diwou/hubby_seventy_five/kicad/fab/rev0.3/bom/bom.csv

Designator | Footprint | Quantity | Value | LCSC Part #
BT1 | BatteryHolder_MYOUNG_BS-07-A1BJ001_CR2032 | 1 | CR2032
C1, C10, C11, C13, C2, C28, C3, C4, C7, C9 | 0805 | 10 | 100n
C12 | 0805 | 1 | 1µ
C27, C5, C6, C8 | 0805 | 4 | 10µ
D1 | D_SMA | 1 | SS14
D2 | 0805 | 1 | PWR
J1 | USB_C_Receptacle_GCT_USB4105-xx-A_16P_TopMnt_Horizontal | 1 | USB_C_Receptacle_USB2.0_16P
J2 | JST_VH_B4P-VH_1x04_P3.96mm_Vertical | 1 | PWR IN
J3 | IDC-Header_2x08_P2.54mm_Vertical | 1 | HUB75 Connector
R1, R2 | 0805 | 2 | 5k1
R10, R11, R6, R8, R9 | 0805 | 5 | 10k
R27 | 0805 | 1 | 10
R3, R4, R5 | 0805 | 3 | 4k7
R7 | 0805 | 1 | 1k
SW1 | SW_PUSH_6mm | 1 | Reset
SW2 | SW_PUSH_6mm | 1 | Factory Reset
SW3 | SW_PUSH_6mm | 1 | Boot
U1 | SOT-223-3_TabPin2 | 1 | TLV76133DCY
U2 | SOIC-16W_7.5x10.3mm_P1.27mm | 1 | DS3231S
U21 | XDCR_VEML7700-TT | 1 | VEML7700-TT
U3, U6 | TSSOP-20_4.4x6.5mm_P0.65mm | 2 | 74HCT245
U4 | Bosch_LGA-8_3x3mm_P0.8mm_ClockwisePinNumbering | 1 | BME680
U5 | ESP32-S3-WROOM-1 | 1 | ESP32-S3-WROOM-1
