diwou/hubby_seventy_five/kicad/source/Hubby Seventy Five.kicad_pcb

## KiCad design kicad/source/Hubby Seventy Five.kicad_pcb (2026-04-23)

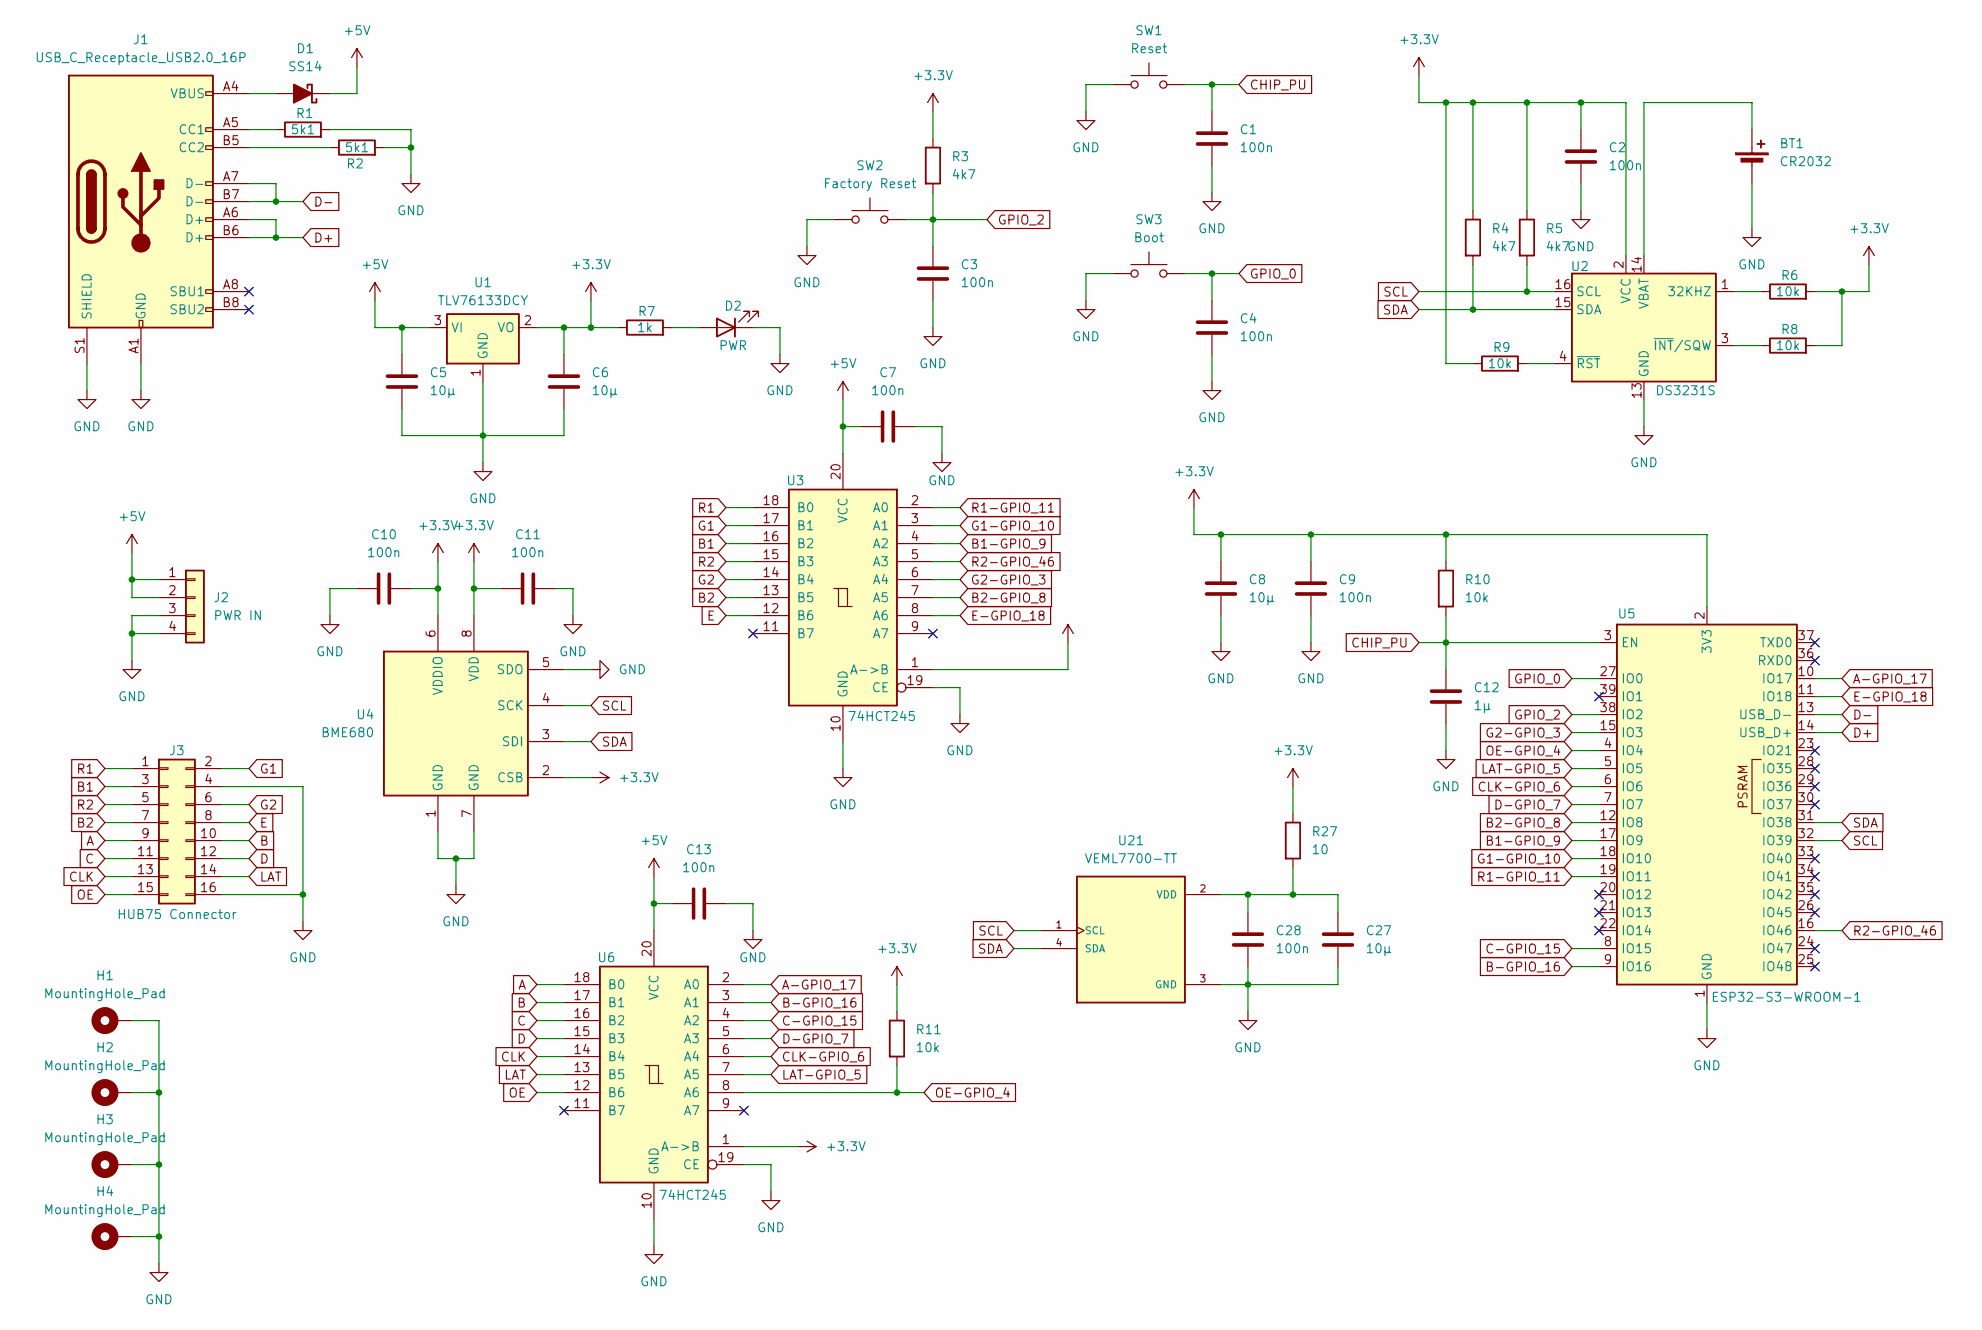
[picture p1: schematic Hubby Seventy Five.kicad_sch]

Parts:
BT1: CR2032; BatteryHolder_MYOUNG_BS-07-A1BJ001_CR2032
C1, C2, C3, C4, C7, C9, C10, C11, C13, C28: 100n; C_0805_2012Metric_Pad1.18x1.45mm_HandSolder
C5, C6, C8, C27: 10µ; C_0805_2012Metric_Pad1.18x1.45mm_HandSolder
C12: 1µ; C_0805_2012Metric_Pad1.18x1.45mm_HandSolder
D1: SS14; D_SMA
D2: PWR; LED_0805_2012Metric_Pad1.15x1.40mm_HandSolder
H1, H2, H3, H4: MountingHole_Pad; MountingHole_3.2mm_M3_DIN965_Pad
J1: USB_C_Receptacle_USB2.0_16P; USB_C_Receptacle_GCT_USB4105-xx-A_16P_TopMnt_Horizontal
J2: PWR IN; JST_VH_B4P-VH_1x04_P3.96mm_Vertical
J3: HUB75 Connector; IDC-Header_2x08_P2.54mm_Vertical
R1, R2: 5k1; R_0805_2012Metric_Pad1.20x1.40mm_HandSolder
R3, R4, R5: 4k7; R_0805_2012Metric_Pad1.20x1.40mm_HandSolder
R6, R8, R9, R10, R11: 10k; R_0805_2012Metric_Pad1.20x1.40mm_HandSolder
R7: 1k; R_0805_2012Metric_Pad1.20x1.40mm_HandSolder
R27: 10; R_0805_2012Metric_Pad1.20x1.40mm_HandSolder
SW1: Reset; SW_PUSH_6mm
SW2: Factory Reset; SW_PUSH_6mm
SW3: Boot; SW_PUSH_6mm
U1: TLV76133DCY; SOT-223-3_TabPin2
U2: DS3231S; SOIC-16W_7.5x10.3mm_P1.27mm
U3, U6: 74HCT245; TSSOP-20_4.4x6.5mm_P0.65mm
U4: BME680; Bosch_LGA-8_3x3mm_P0.8mm_ClockwisePinNumbering
U5: ESP32-S3-WROOM-1
U21: VEML7700-TT; XDCR_VEML7700-TT; PARTREV 1.6

Connections:
+3.3V: C2.1, C6.1, C8.1, C9.1, C10.2, C11.1, R3.1, R4.1, R5.1, R6.2, R7.1, R8.2, R9.1, R10.1, R11.1, R27.1, U1.2 (VO), U2.2 (VCC), U3.1 (A->B), U4.2 (CSB), U4.6 (VDDIO), U4.8 (VDD), U5.2 (3V3), U6.1 (A->B)
+5V: C5.1, C7.1, C13.1, D1.1 (K), J2.1, J2.2, U1.3 (VI), U3.20 (VCC), U6.20 (VCC)
A: J3.9, U6.18 (B0)
A-GPIO_17: U5.10 (IO17), U6.2 (A0)
B: J3.10, U6.17 (B1)
B1: J3.3, U3.16 (B2)
B1-GPIO_9: U3.4 (A2), U5.17 (IO9)
B2: J3.7, U3.13 (B5)
B2-GPIO_8: U3.7 (A5), U5.12 (IO8)
B-GPIO_16: U5.9 (IO16), U6.3 (A1)
C: J3.11, U6.16 (B2)
C-GPIO_15: U5.8 (IO15), U6.4 (A2)
CHIP_PU: C1.1, C12.1, R10.2, SW1.2, U5.3 (EN)
CLK: J3.13, U6.14 (B4)
CLK-GPIO_6: U5.6 (IO6), U6.6 (A4)
D: J3.12, U6.15 (B3)
D+: J1.A6 (D+), J1.B6 (D+), U5.14 (USB_D+)
D-: J1.A7 (D-), J1.B7 (D-), U5.13 (USB_D-)
D-GPIO_7: U5.7 (IO7), U6.5 (A3)
E: J3.8, U3.12 (B6)
E-GPIO_18: U3.8 (A6), U5.11 (IO18)
G1: J3.2, U3.17 (B1)
G1-GPIO_10: U3.3 (A1), U5.18 (IO10)
G2: J3.6, U3.14 (B4)
G2-GPIO_3: U3.6 (A4), U5.15 (IO3)
GND: BT1.2 (-), C1.2, C2.2, C3.2, C4.2, C5.2, C6.2, C7.2, C8.2, C9.2, C10.1, C11.2, C12.2, C13.2, C27.2, C28.2, D2.1 (K), H1.1, H2.1, H3.1, H4.1, J1.A1 (GND), J1.A12 (GND), J1.B1 (GND), J1.B12 (GND), J1.S1 (SHIELD), J2.3, J2.4, J3.4, J3.16, R1.2, R2.2, SW1.1, SW2.1, SW3.1, U1.1 (GND), U2.5 (GND), U2.6 (GND), U2.7 (GND), U2.8 (GND), U2.9 (GND), U2.10 (GND), U2.11 (GND), U2.12 (GND), U2.13 (GND), U3.10 (GND), U3.19 (CE), U4.1 (GND), U4.5 (SDO), U4.7 (GND), U5.1 (GND), U5.40 (GND), U5.41 (GND), U6.10 (GND), U6.19 (CE), U21.3 (GND)
GPIO_0: C4.1, SW3.2, U5.27 (IO0)
GPIO_2: C3.1, R3.2, SW2.2, U5.38 (IO2)
LAT: J3.14, U6.13 (B5)
LAT-GPIO_5: U5.5 (IO5), U6.7 (A5)
unnamed: BT1.1 (+), U2.14 (VBAT)
unnamed: D1.2 (A), J1.A4 (VBUS), J1.A9 (VBUS), J1.B4 (VBUS), J1.B9 (VBUS)
unnamed: D2.2 (A), R7.2
unnamed: J1.A5 (CC1), R1.1
unnamed: J1.B5 (CC2), R2.1
unnamed: R6.1, U2.1 (32KHZ)
unnamed: R8.1, U2.3 (~INT/SQW)
unnamed: R9.2, U2.4 (~RST)
unnamed: C27.1, C28.1, R27.2, U21.2 (VDD)
OE: J3.15, U6.12 (B6)
OE-GPIO_4: R11.2, U5.4 (IO4), U6.8 (A6)
R1: J3.1, U3.18 (B0)
R1-GPIO_11: U3.2 (A0), U5.19 (IO11)
R2: J3.5, U3.15 (B3)
R2-GPIO_46: U3.5 (A3), U5.16 (IO46)
SCL: R5.2, U2.16 (SCL), U4.4 (SCK), U5.32 (IO39), U21.1 (SCL)
SDA: R4.2, U2.15 (SDA), U4.3 (SDI), U5.31 (IO38), U21.4 (SDA)

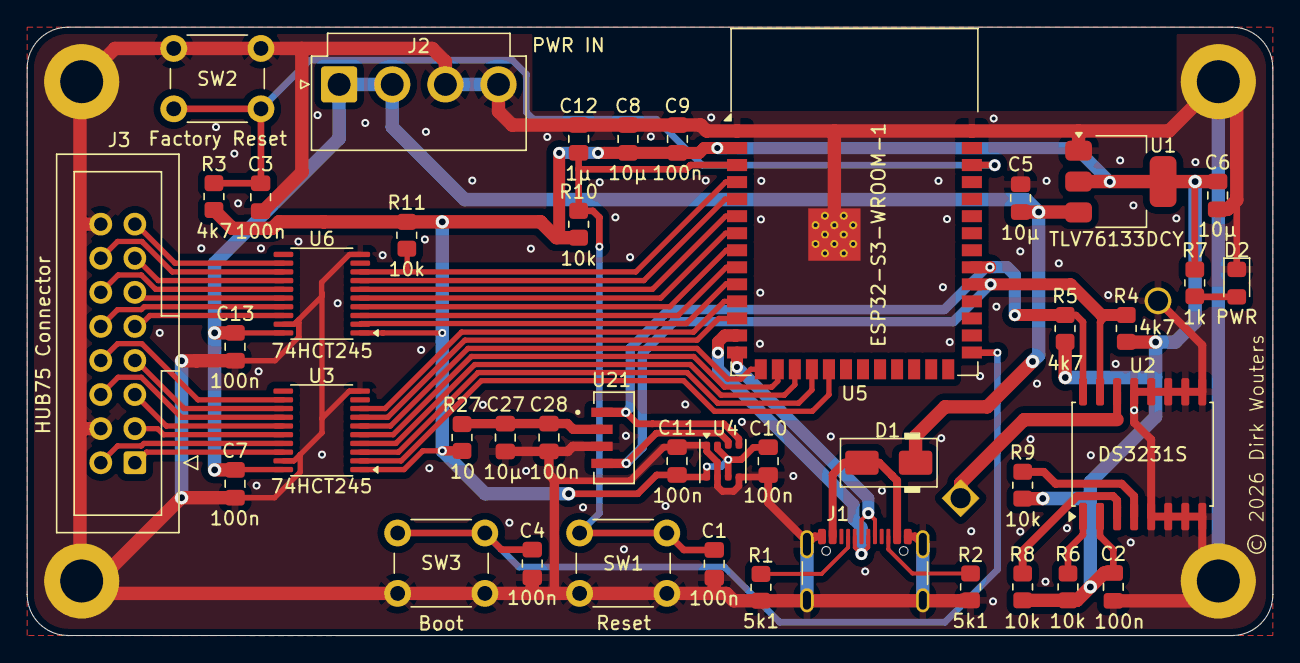
[picture p2: board Hubby Seventy Five.kicad_pcb from above]

Board: 2 copper layers, 92.8 x 45.3 mm, 47 parts (1 on the bottom side), 47 nets.
