diwou/hubby_seventy_five/(commit log)

2026-04-06 Add installer button to README
2026-04-10 fix: refine forecast spacing and enlarge clock
    [display.h]
2026-04-10 fix: use taller hhmm clock glyphs
    [display.h]
2026-04-10 fix: replace ineffective clock scaling with tall hhmm renderer
    [display.h]
2026-04-10 fix: enlarge hhmmss and clear mode switch artifacts
    [display.h]
2026-04-10 fix: switch clock digits to bitmap-style scaling
    [display.h]
2026-04-10 fix: finalize hhmmss layout and ota display lock
    [display.h, webserver.h]
2026-04-10 fix: rebalance hhmmss colon spacing
    [display.h]
2026-04-19 Fix brief display blanks
    [config.h, display.h]
2026-04-19 Fix forecast transition clipping
    [display.h]
2026-04-19 Replace task WDT with heartbeat monitor
    [main.cpp]
2026-04-19 Add KiCad source and fabrication exports
    [Hubby Seventy Five-B_Cu.gbl, Hubby Seventy Five-B_Mask.gbs, Hubby Seventy Five-B_Paste.gbp, Hubby Seventy Five-B_Silkscreen.gbo, Hubby Seventy Five-Edge_Cuts.gm1, Hubby Seventy Five-F_Cu.gtl, Hubby Seventy Five-F_Mask.gts, Hubby Seventy Five-F_Paste.gtp]
2026-04-19 Move KiCad fab zip to revision root
2026-04-19 Add human-readable KiCad BOM summary
2026-04-19 Fix watchdog and regenerate KiCad BOM summary
    [main.cpp, webserver.h]
2026-04-19 Avoid blocking weather fetch during startup
    [main.cpp]
2026-04-19 Reset WiFi stack on boot
    [main.cpp]
2026-04-19 Smooth current weather scroll
2026-04-19 Stabilize weather scroll timing
    [display.h]
2026-04-19 Reset weather scroll after forecast
    [display.h]
2026-04-19 Avoid full weather band redraw
    [display.h]
2026-04-19 Revert PSRAM double buffering
    [display.h]
2026-04-19 Revert weather scroll experiments
    [display.h]
2026-04-19 Smooth current weather scroll with supersampling
2026-04-19 Document smoother current weather scroll
2026-04-19 Try smoother weather scroll with fixed-point timing
    [display.h]
2026-04-19 Reset weather scroll timing on restart
    [display.h]
2026-04-19 Smooth current weather with 2x intermediate buffer
2026-04-19 Revert broken current weather 2x scroll experiment
    [display.h]
2026-04-19 Reset weather scroll after forecast transition
    [display.h]
2026-04-23 Update KiCad assets to rev0.3
    [Hubby Seventy Five-B_Cu.gbl, Hubby Seventy Five-B_Mask.gbs, Hubby Seventy Five-B_Paste.gbp, Hubby Seventy Five-B_Silkscreen.gbo, Hubby Seventy Five-Edge_Cuts.gm1, Hubby Seventy Five-F_Cu.gtl, Hubby Seventy Five-F_Mask.gts, Hubby Seventy Five-F_Paste.gtp]
2026-04-23 Document KiCad release workflow
2026-04-24 fix: HH:MM:SS auf 7px verbreitert
    [display.h]
2026-04-24 fix: HH:MM:SS im Legacy-Pfad verbreitert
    [display.h]
2026-04-24 fix: HH:MM:SS-Kantenbreite ohne Lochverlust
    [display.h]
2026-04-24 fix: HH:MM:SS mit eigenem 7px-Font
    [display.h]
2026-04-24 fix: HH:MM:SS auf volle Hoehe zurueck
    [display.h]
2026-04-24 fix: HH:MM:SS-Font mit 2px-Strichen
    [display.h]
2026-04-24 revert: heutige Font-Änderungen zurücknehmen
    [display.h]
2026-04-24 fix: HH:MM:SS-Font auf 7x14-Tabelle umstellen
    [display.h]
2026-04-24 fix: HH:MM:SS-Abstaende nach den Doppelpunkten korrigieren
    [display.h]
2026-04-24 fix: HH:MM:SS-Ziffer 6 korrigieren
    [display.h]
2026-04-26 fix: sichere Web-API und Versionsquelle
    [config.h, display.h, main.cpp, webserver.h]
2026-04-27 fix: Wetterabruf beim Boot entkoppeln
    [config.h, display.h, main.cpp, weather.h, webserver.h]
2026-04-28 fix: glaette Wetter-Scroll per Subpixel-Blending
    [display.h]
2026-04-28 fix: entferne unscharfes Wetter-Scroll-Blending
    [display.h]
2026-04-28 fix: entlaste OTA und beschleunige Wetter-Scroll
    [config.h, display.h]
2026-04-30 fix: stabilize cold boot startup
    [main.cpp]
2026-05-11 feat: DS3231-Zeitquelle und RTC-Webfunktionen integrieren
2026-05-11 feat: erweitere RTC/VEML status und kompakte 1x-forecast darstellung
2026-05-11 docs: aktualisiere changelog referenzen fuer rtc-veml und forecast-fix
2026-05-11 fix: stabilisiere autohelligkeit und strukturiere status-tabs
    [main.cpp, webserver.h]
2026-05-11 feat: integriere bme680 wetterdaten und passe 1x-forecast spacing an
2026-05-11 docs: aktualisiere changelog-referenzen fuer bme680 und forecast-spacing
2026-05-11 fix: entkopple bme680 messung vom render-loop
    [main.cpp]
2026-05-11 fix: stoppe bme680 polling waehrend wetter-wait und setze 2px spacing
    [display.h, main.cpp]
2026-05-11 fix: justiere forecast-abstaende fuer 1x display
    [display.h]
2026-05-11 fix: aktualisiere statusdaten ajax-weit in allen tabs
    [webserver.h]
2026-05-11 fix: deaktiviere bme680 heater fuer stabile umgebungstemperatur
    [main.cpp]
2026-05-11 docs: aktualisiere changelog-referenz fuer bme680-heater-fix
2026-05-11 fix: erzwinge bme680 update alle 2 sekunden
    [main.cpp]
2026-05-11 fix: korrigiere bme680 async ready-zeitpunkt
    [main.cpp]
2026-05-11 fix: verbessere bme680 reaktionsverhalten und lesefallback
    [main.cpp]
2026-05-12 fix(ntp): Sync-Intervall und TZ-Handling robust machen
    [config.h, webserver.h]
2026-05-12 fix(time): RTC als UTC fuehren und echten NTP-Resync ausfuehren
    [main.cpp]
2026-05-12 fix(time): DS3231-Stundenformat robust lesen und NTP als Live-Zeitquelle nutzen
    [main.cpp]
2026-05-12 fix(time): DS3231-UTC-Dekodierung auf Dottie-Stand angleichen
    [main.cpp]
2026-05-12 fix(time): NTP-Syncpfad aus Dottie per UDP-Probe uebernehmen
    [main.cpp]
2026-05-12 fix(ntp): Sync-Intervall auf min=1 umstellen
    [config.h, webserver.h]
2026-05-13 fix(display): sichtbaren Slide-Up beim Ziffernwechsel wiederherstellen
    [display.h]
