diwou/hubby_seventy_five/(notices)

Notices in the files:
kicad/source/Hubby Seventy Five.kicad_pcb:
© 2026 Dirk Wouters
License: CC BY-NC-SA 4.0
